Jaystonian/1581-Improved/photos/IMG_20250410_140211_095.jpg

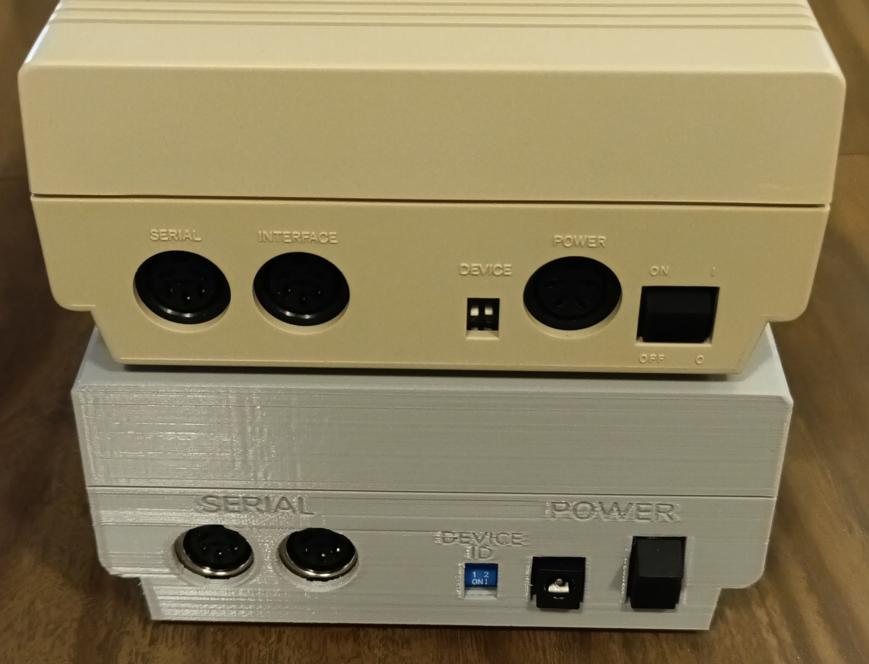
photos/IMG_20250410_140211_095.jpg
