Jaystonian/1581-Improved/photos/IMG_20250410_140146_087.jpg

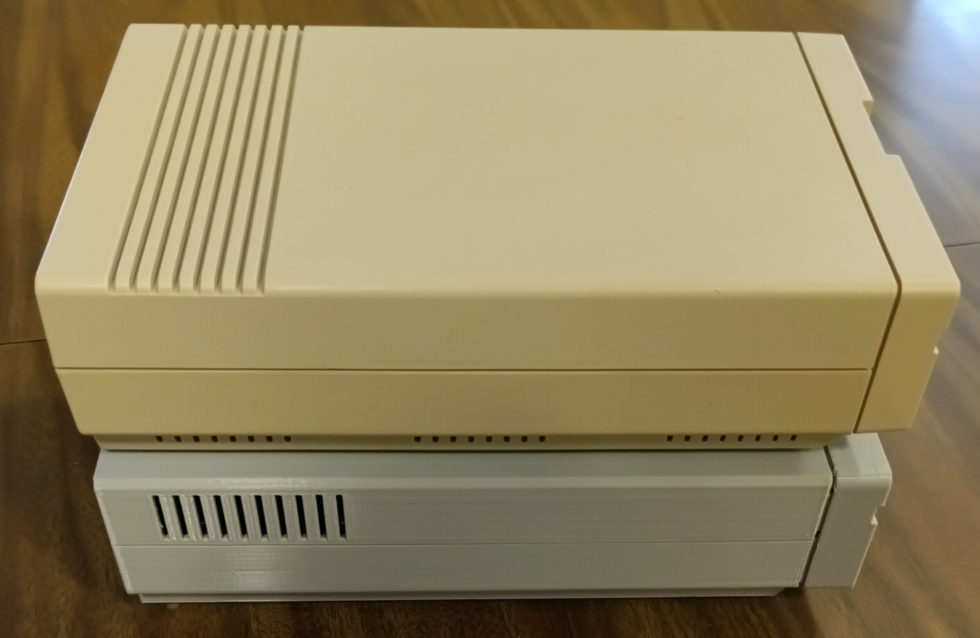
photos/IMG_20250410_140146_087.jpg
