Jaystonian/1581-Improved/photos/1581-improved-bottom.png

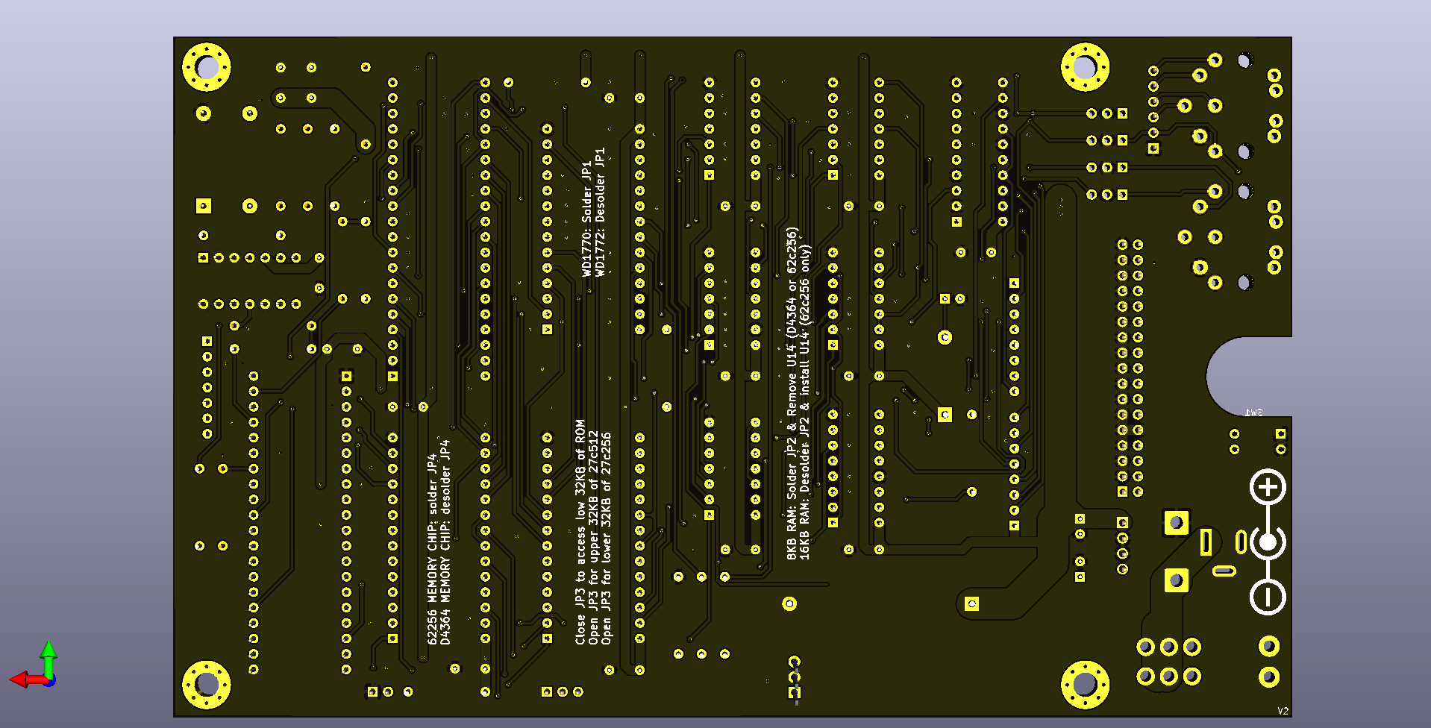
photos/1581-improved-bottom.png
