Jaystonian/1581-Improved/photos/1581-improved-top.png

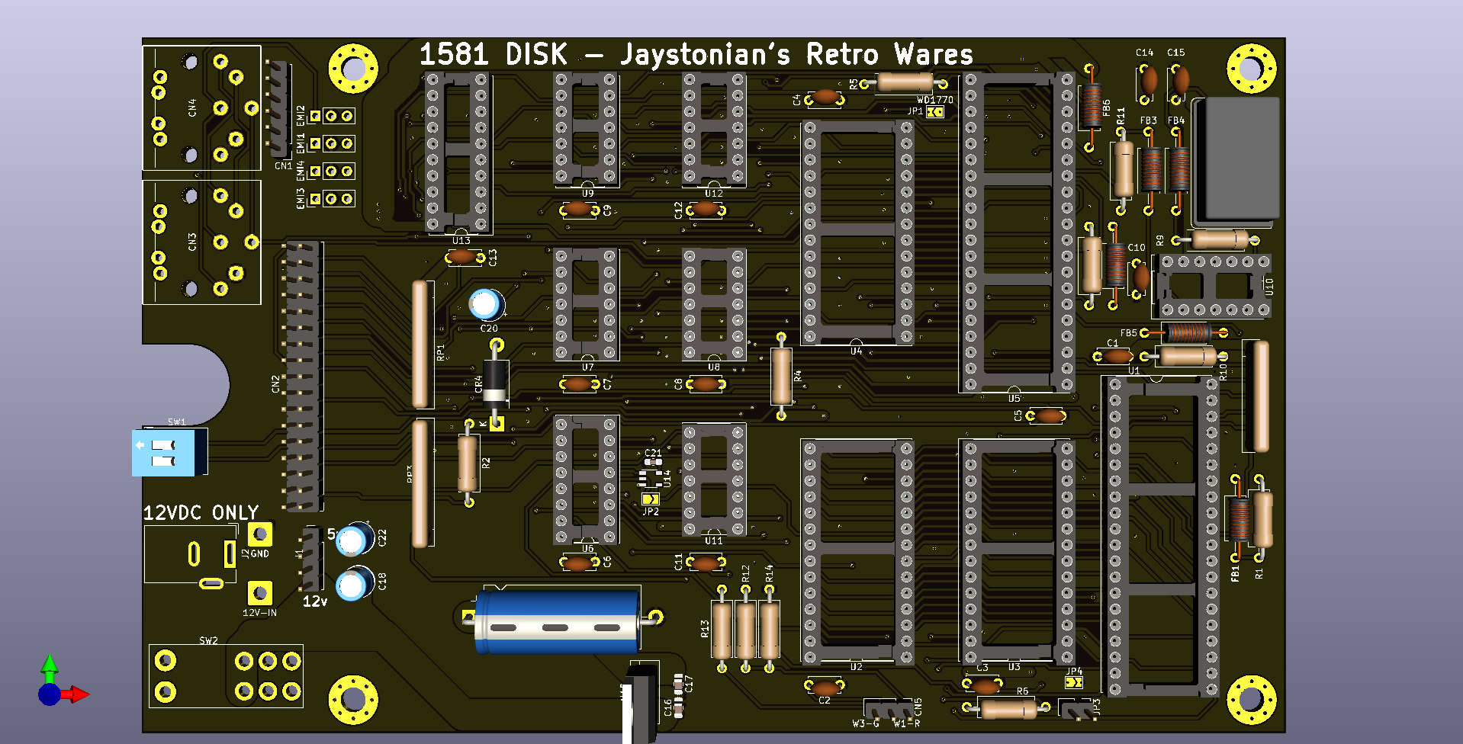
photos/1581-improved-top.png
