Jaystonian/1581-Improved/photos/IMG_20250410_140110_550.jpg

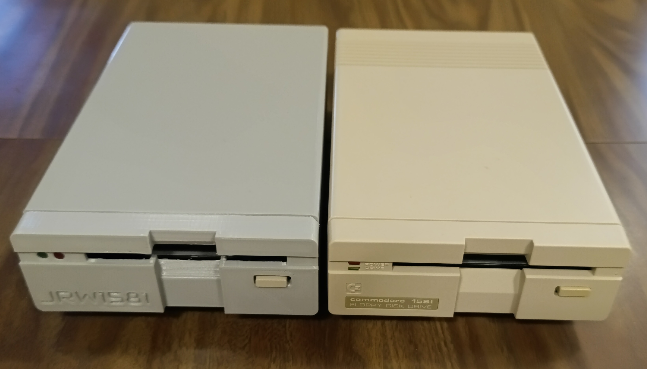
photos/IMG_20250410_140110_550.jpg
