Jaystonian/1581-Improved/STL/JRW1581-Face-HD.stl

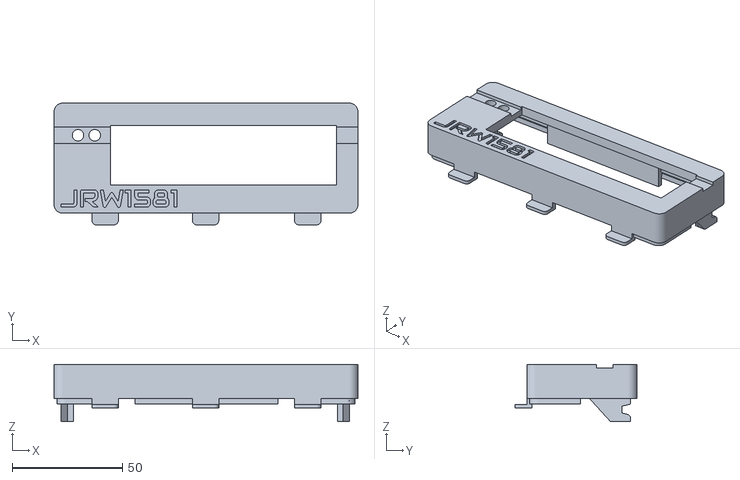
[picture p7: CAD file, 2025-04-21]
STL/JRW1581-Face-HD.stl
138.0 x 55.3 x 26.0
