Jaystonian/1581-Improved/STL/JRW1581-Face-DD-WithSupports.stl

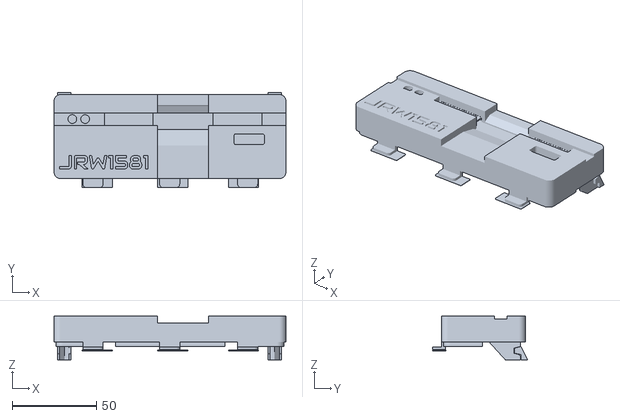
[picture p8: CAD file, 2025-04-21]
STL/JRW1581-Face-DD-WithSupports.stl
138.0 x 56.7 x 26.0
