Jaystonian/1581-Improved/STL/JRW1581-Face-HD-WithSupports.stl

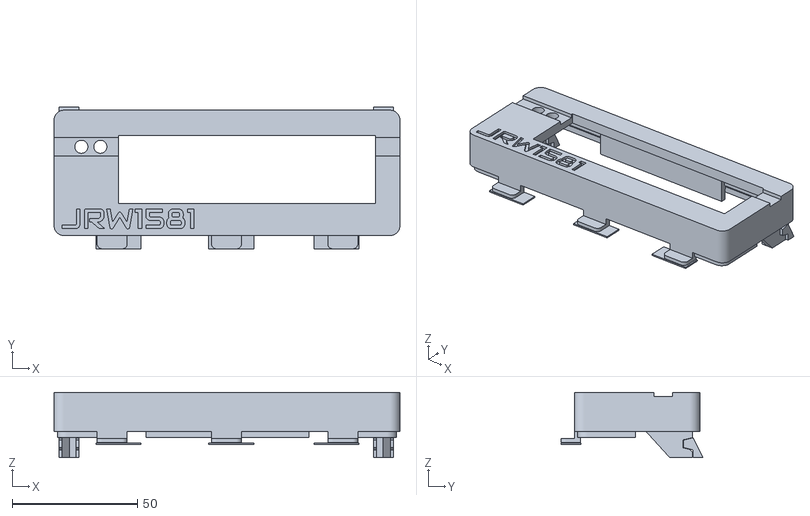
[picture p9: CAD file, 2025-04-21]
STL/JRW1581-Face-HD-WithSupports.stl
138.0 x 56.7 x 26.0
