Jaystonian/1581-Improved/STL/JRW1581-DriveMount-DD.stl

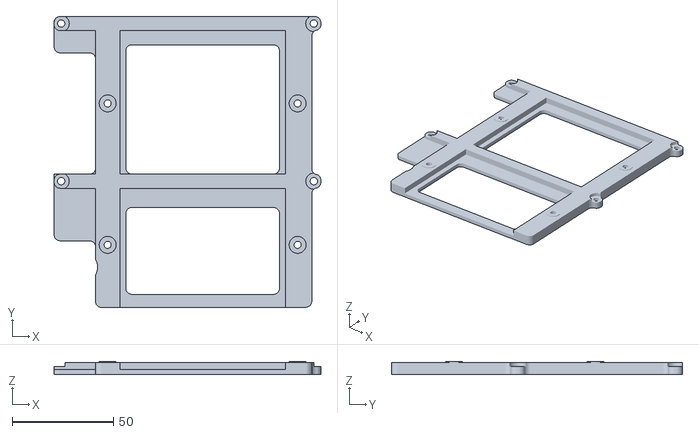
[picture p10: CAD file, 2025-04-21]
STL/JRW1581-DriveMount-DD.stl
132.0 x 144.0 x 6.40
