Jaystonian/1581-Improved/STL/JRW1581-Top.stl

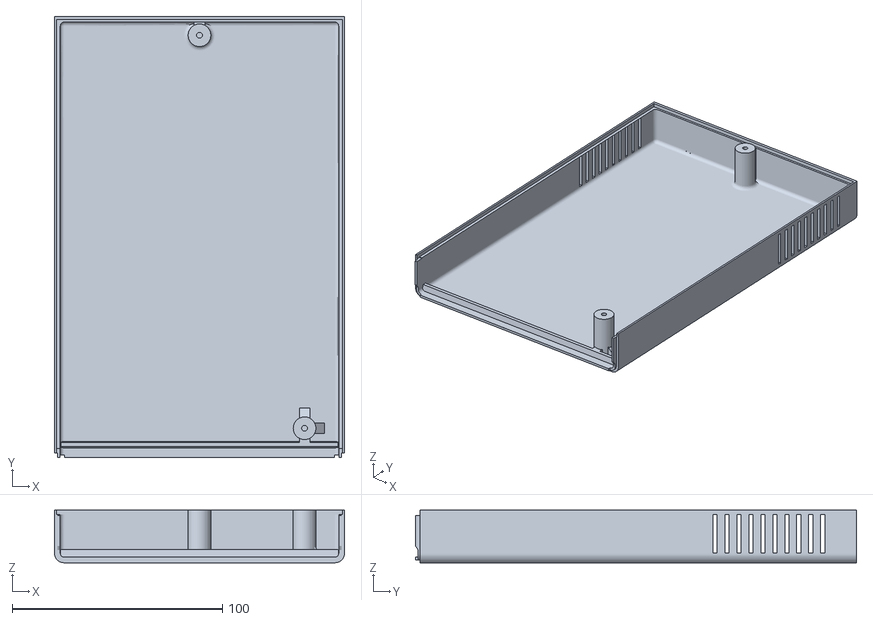
[picture p11: CAD file, 2025-04-10]
STL/JRW1581-Top.stl
138.0 x 210.0 x 25.0
