Jaystonian/1581-Improved/STL/JRW1581-Bottom-With-Print-Supports.stl

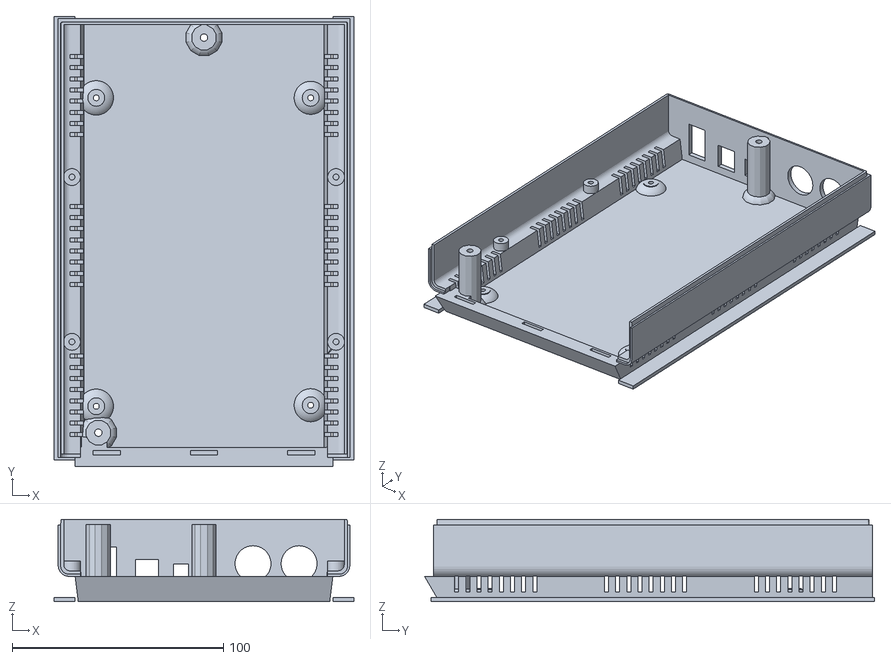
[picture p12: CAD file, 2025-04-10]
STL/JRW1581-Bottom-With-Print-Supports.stl
142.0 x 213.0 x 39.0
