Jaystonian/1581-Improved/STL/JRW1581-Top-With-Print-Support.stl

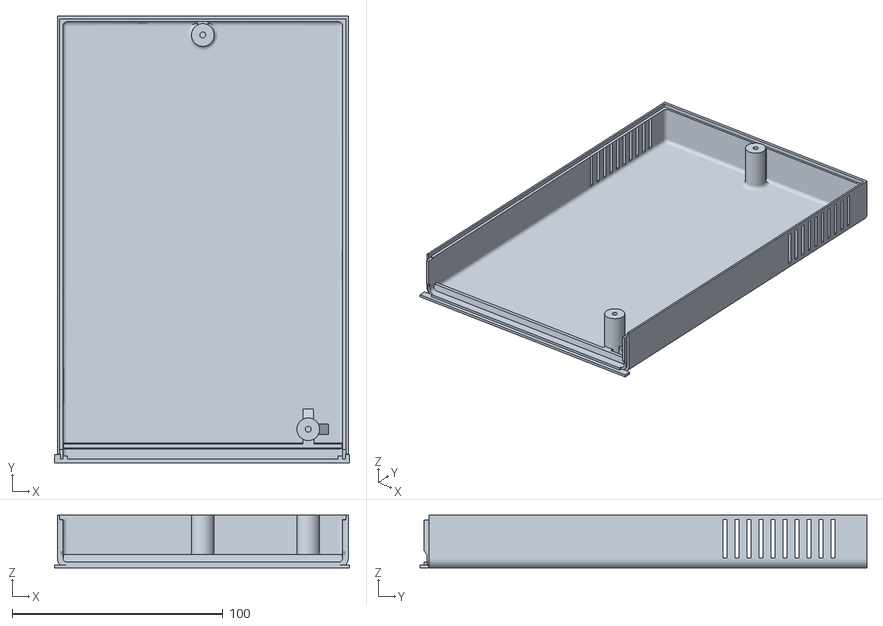
[picture p13: CAD file, 2025-04-10]
STL/JRW1581-Top-With-Print-Support.stl
140.0 x 212.0 x 25.0
