Jaystonian/1581-Improved/STL/JRW1581-Bottom.stl

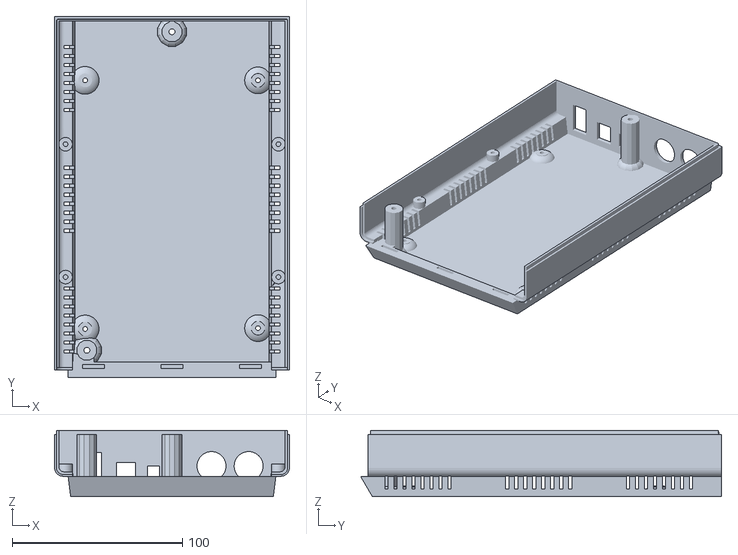
[picture p14: CAD file, 2025-04-10]
STL/JRW1581-Bottom.stl
138.0 x 212.0 x 39.0
