Jaystonian/1581-Improved/(list of files, cad)

Other CAD files:
STL/JRW1581-DriveMount-HD.stl
