Jaystonian/1581-Improved/PDF/1581-improved.pdf

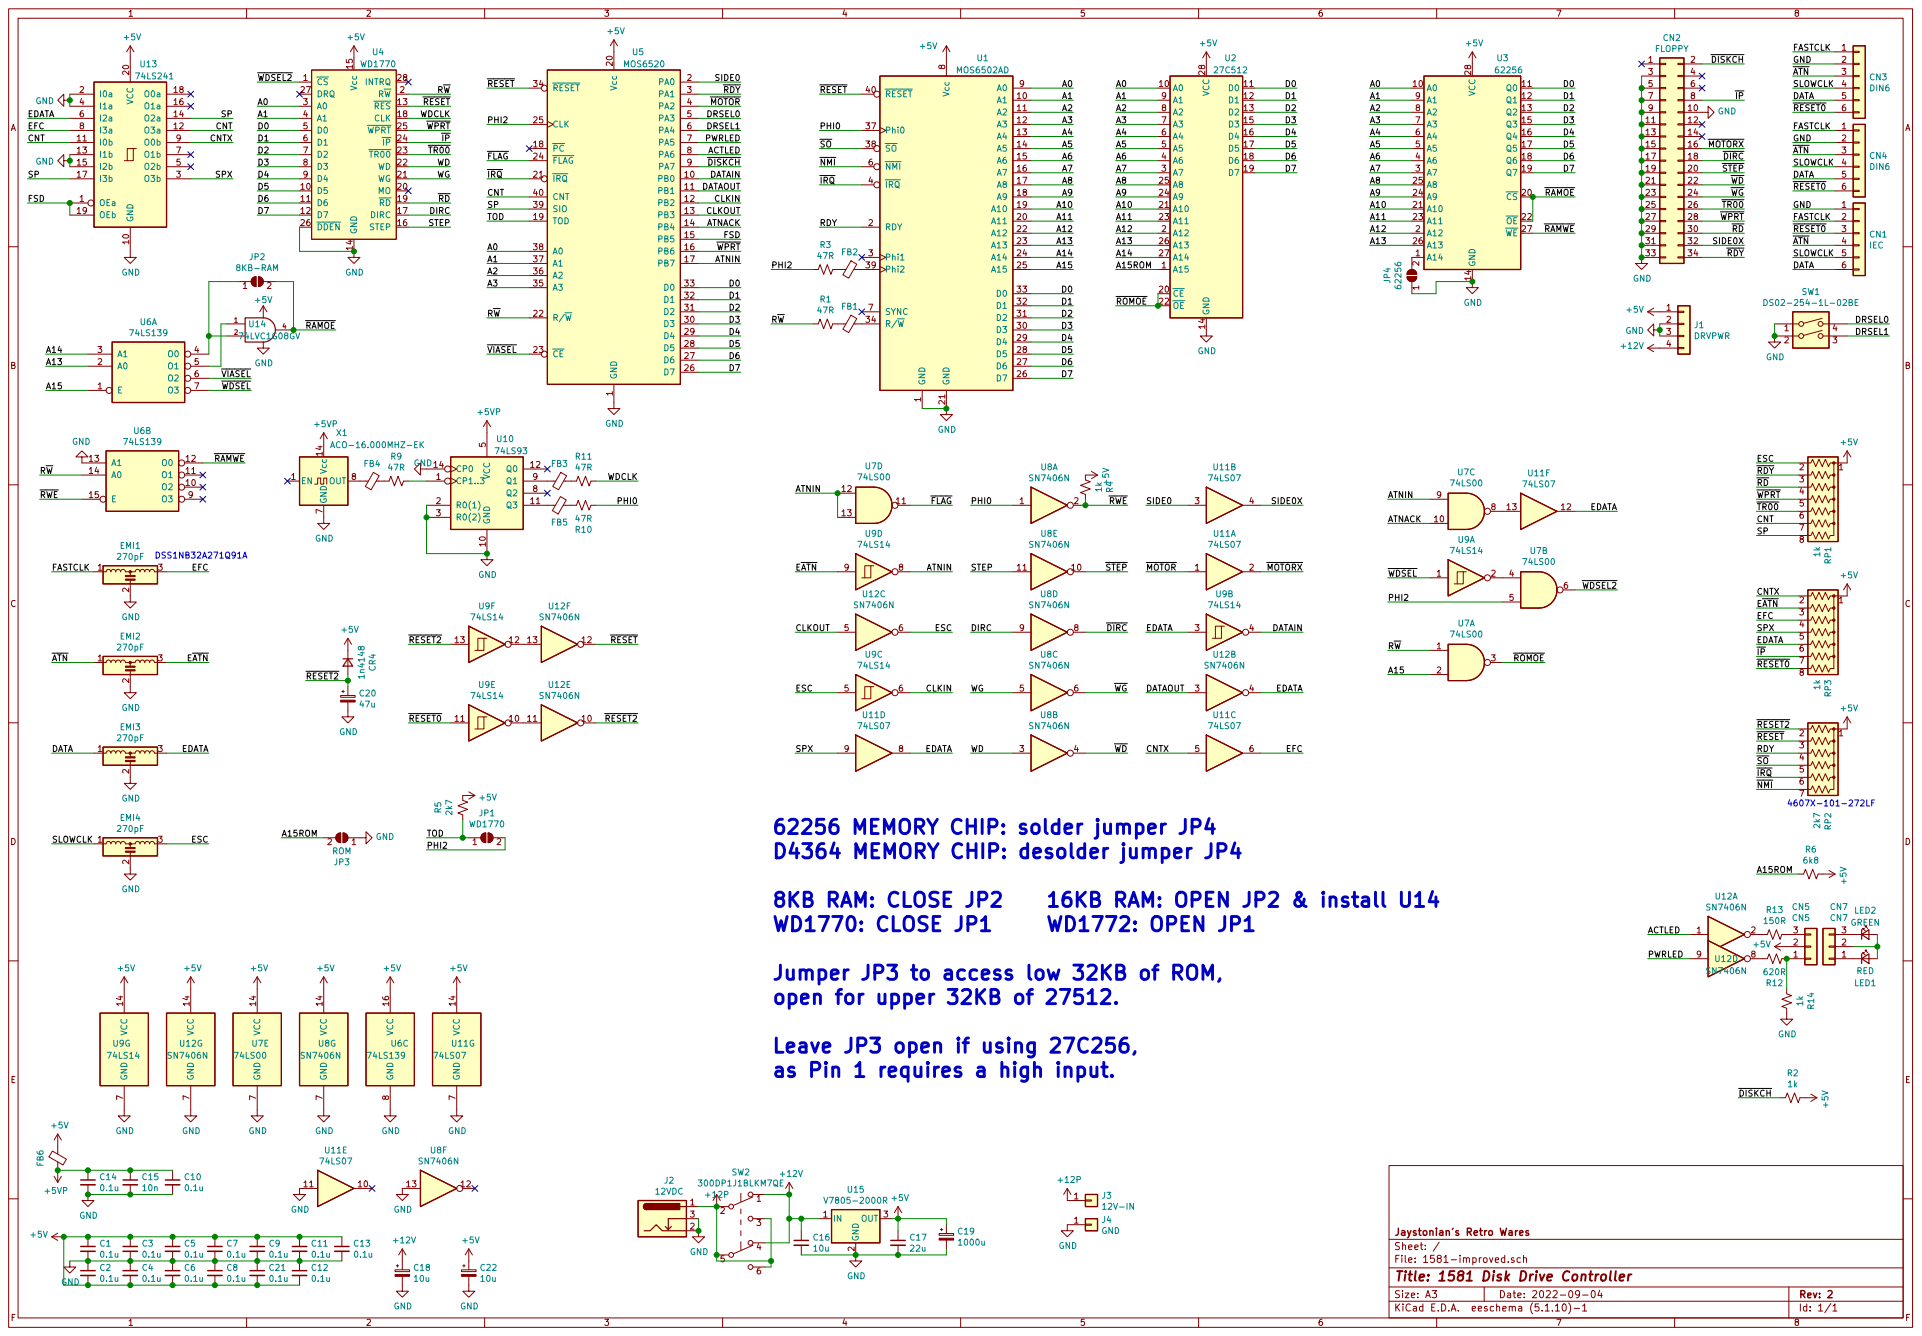
[picture p15: page 1]

D4364 MEMORY CHIP: desolder jumper JP4

File: 1581-improved.sch Sheet: / Jaystonian's Retro Wares GND GND

8KB RAM: CLOSE JP2 16KB RAM: OPEN JP2 & install U14
WD1770: CLOSE JP1 WD1772: OPEN JP1

Jumper JP3 to access low 32KB of ROM,
open for upper 32KB of 27512.

Leave JP3 open if using 27C256,
as Pin 1 requires a high input.

Id: 1/1 Title: 1581 Disk Drive Controller
