Jaystonian/1581-Improved/kicad/1581-improved.kicad_pcb

## KiCad design kicad/1581-improved.kicad_pcb (2025-04-11)

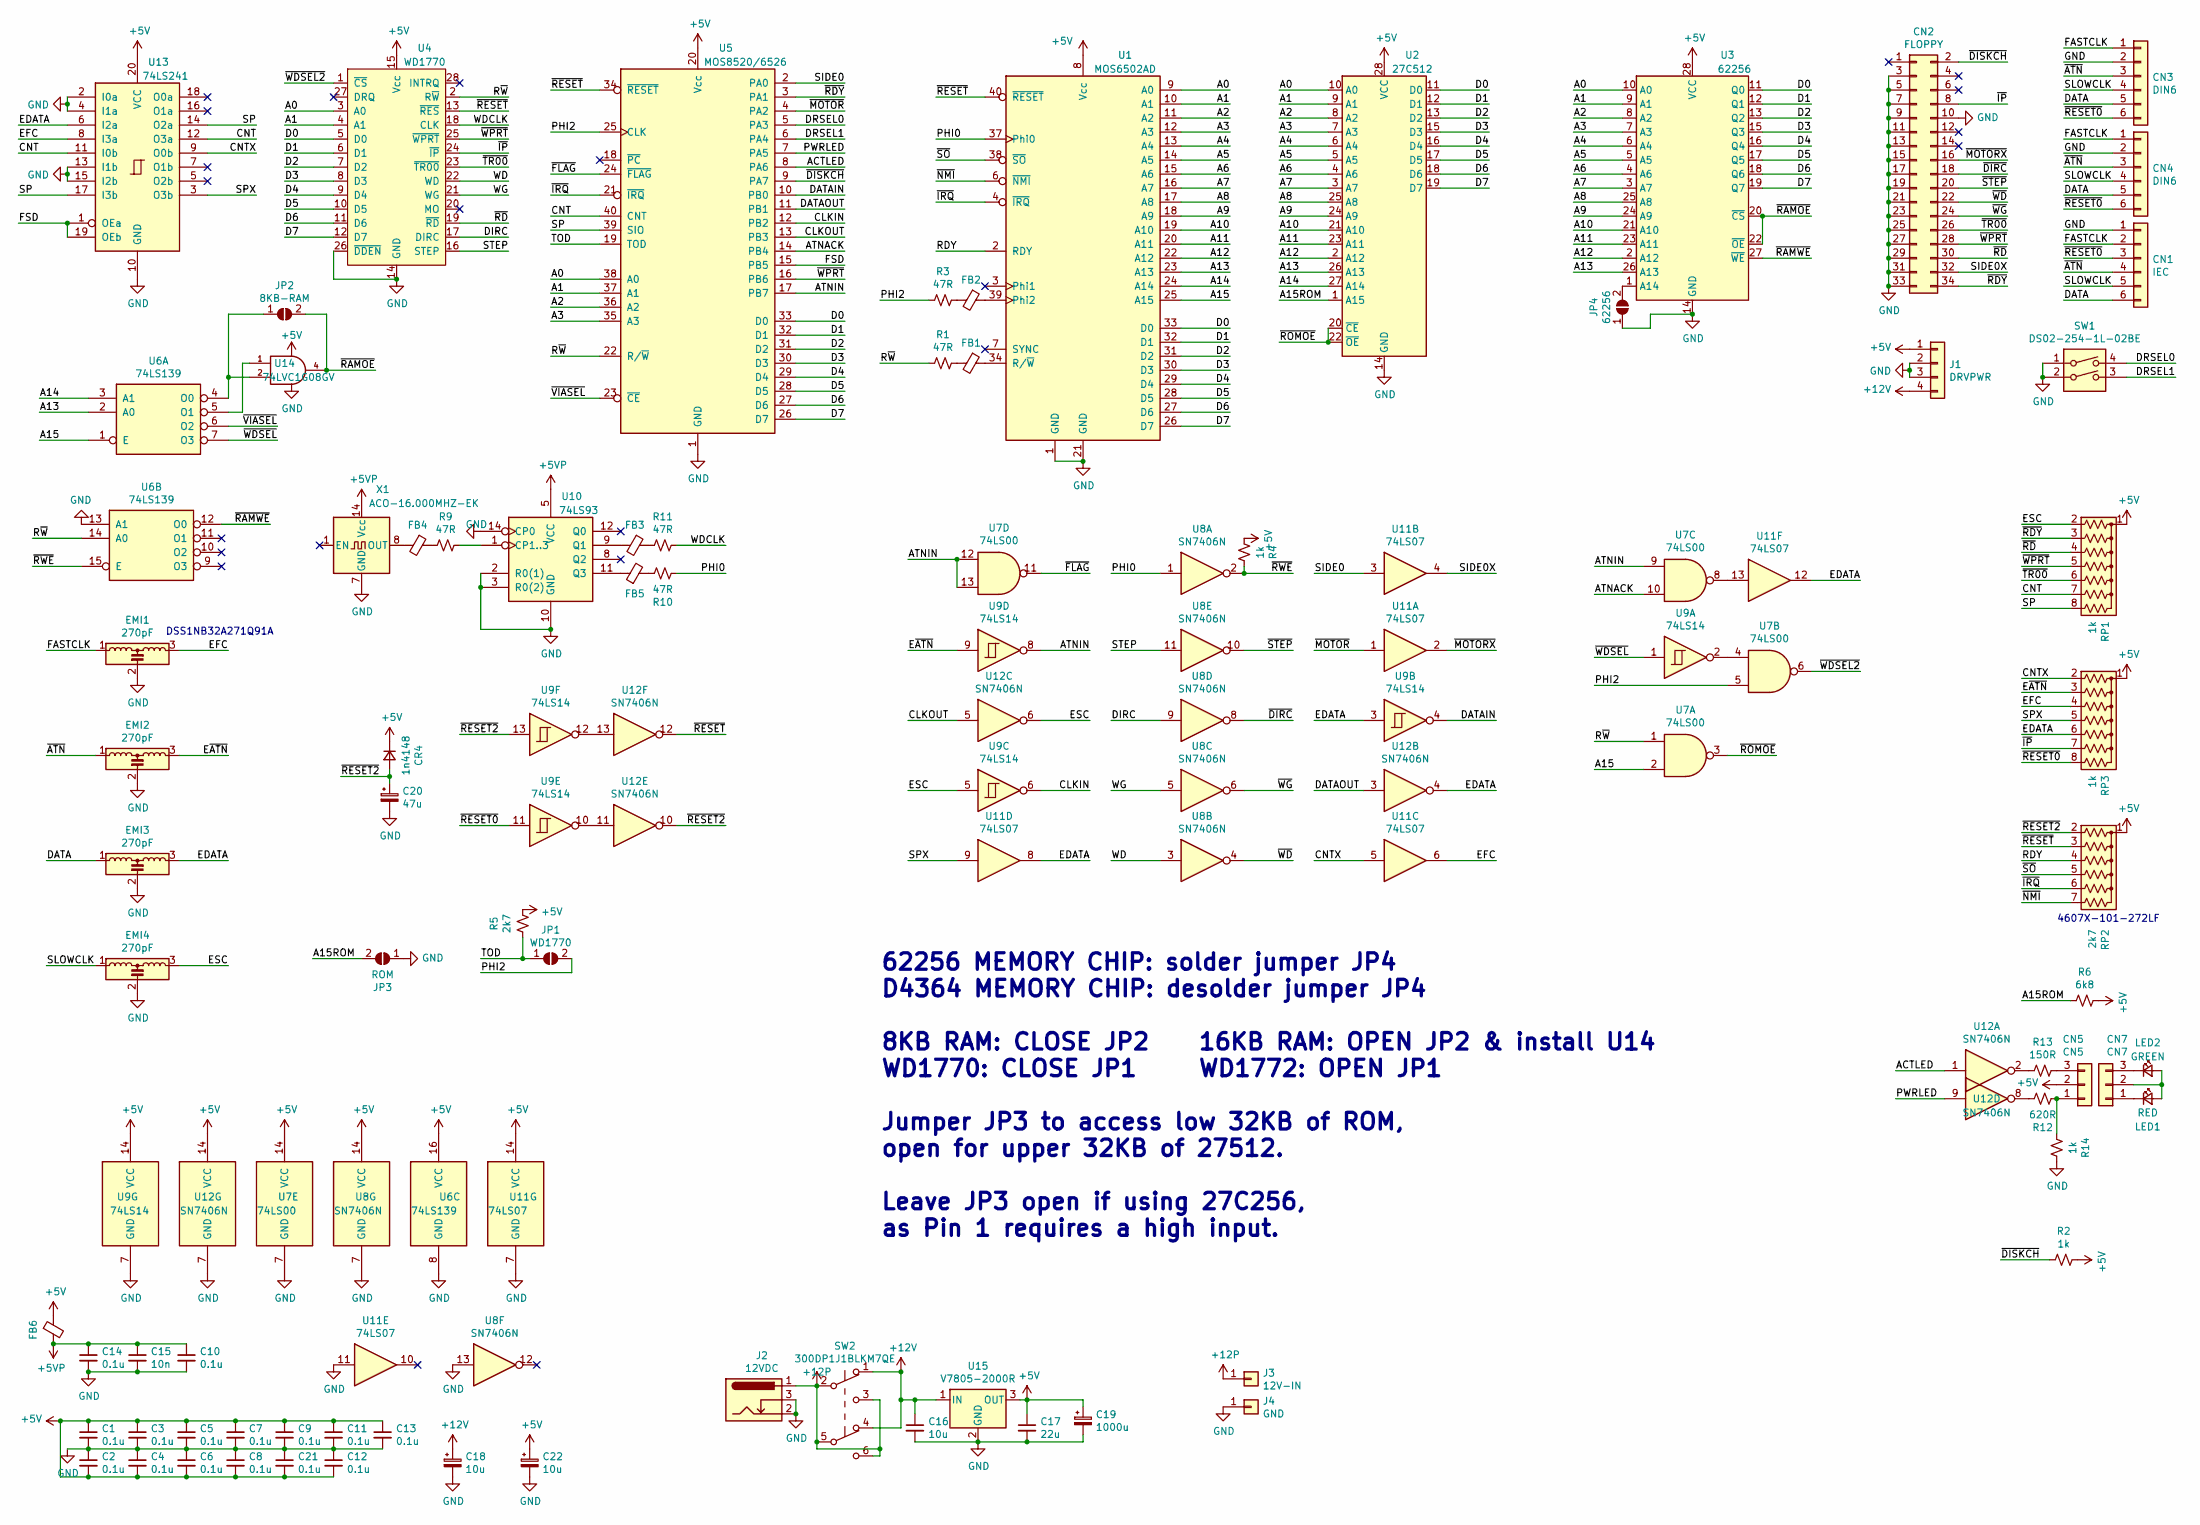
[picture p16: schematic 1581-improved.kicad_sch, 1581 Disk Drive Controller]

Parts:
C1, C2, C3, C4, C5, C6, C7, C8, C9, C10, C11, C12, C13, C14: 0.1u; C_Disc_D5.0mm_W2.5mm_P5.00mm
C15: 10n; C_Disc_D5.0mm_W2.5mm_P5.00mm
C16: 10u; C_0805_2012Metric_Pad1.18x1.45mm_HandSolder
C17: 22u; C_0805_2012Metric_Pad1.18x1.45mm_HandSolder
C18, C22: 10u; CP_Radial_D5.0mm_P2.50mm
C19: 1000u; CP_Axial_L25.0mm_D10.0mm_P30.00mm_Horizontal
C20: 47u; CP_Radial_D5.0mm_P2.50mm
C21: 0.1u; C_0603_1608Metric_Pad1.08x0.95mm_HandSolder
CN1: IEC; PinHeader_1x06_P2.54mm_Vertical
CN2: FLOPPY; PinHeader_2x17_P2.54mm_Vertical
CN3, CN4: DIN6; SDF-60J_DIN-6-240
CN5: CN5; PinHeader_1x03_P2.54mm_Vertical
CN7: CN7; PinHeader_1x03_P2.54mm_Vertical
CR4: 1n4148; D_DO-15_P12.70mm_Horizontal
EMI1, EMI2, EMI3, EMI4: 270pF; PinHeader_1x03_P2.54mm_Vertical
FB1, FB2, FB3, FB4, FB5, FB6: Ferrite_Bead_Small; L_Axial_L7.0mm_D3.3mm_P12.70mm_Horizontal_Fastron_MICC
J1: DRVPWR; PinHeader_1x04_P2.54mm_Vertical
J2: 12VDC; BarrelJack_Wuerth_6941xx301002
J3: 12V-IN; SolderWire-1.5sqmm_1x01_D1.7mm_OD3.9mm
J4: GND; SolderWire-1.5sqmm_1x01_D1.7mm_OD3.9mm
JP1: WD1770; SolderJumper-2_P1.3mm_Open_TrianglePad1.0x1.5mm
JP2: 8KB-RAM; SolderJumper-2_P1.3mm_Open_TrianglePad1.0x1.5mm
JP3: ROM; PinHeader_1x02_P2.54mm_Vertical
JP4: 62256; SolderJumper-2_P1.3mm_Open_TrianglePad1.0x1.5mm
LED1: RED; LED_D3.0mm
LED2: GREEN; LED_D3.0mm
R1, R3, R9, R10, R11: 47R; R_Axial_DIN0309_L9.0mm_D3.2mm_P12.70mm_Horizontal
R2, R4, R14: 1k; R_Axial_DIN0309_L9.0mm_D3.2mm_P12.70mm_Horizontal
R5: 2k7; R_Axial_DIN0309_L9.0mm_D3.2mm_P12.70mm_Horizontal
R6: 6k8; R_Axial_DIN0309_L9.0mm_D3.2mm_P12.70mm_Horizontal
R12: 620R; R_Axial_DIN0309_L9.0mm_D3.2mm_P12.70mm_Horizontal
R13: 150R; R_Axial_DIN0309_L9.0mm_D3.2mm_P12.70mm_Horizontal
RP1, RP3: 1k; R_Array_SIP8
RP2: 2k7; R_Array_SIP7
SW1: DS02-254-1L-02BE; SW_DIP_SPSTx02_Slide_9.78x7.26mm_W7.62mm_P2.54mm
SW2: 300DP1J1BLKM7QE; DPDT_1581
U1: MOS6502AD; DIP-40_W15.24mm_Socket
U2: 27C512; DIP-28_W15.24mm_Socket
U3: 62256; DIP-28_W15.24mm_Socket
U4: WD1770; DIP-28_W15.24mm_Socket
U5: MOS8520/6526; DIP-40_W15.24mm_Socket
U6: 74LS139; DIP-16_W7.62mm_Socket
U7: 74LS00; DIP-14_W7.62mm_Socket
U8, U12: SN7406N; DIP-14_W7.62mm_Socket
U9: 74LS14; DIP-14_W7.62mm_Socket
U10: 74LS93; DIP-14_W7.62mm_Socket
U11: 74LS07; DIP-14_W7.62mm_Socket
U13: 74LS241; DIP-20_W7.62mm_Socket
U14: 74LVC1G08GV; SOT-753
U15: V7805-2000R; TO-220-3_Vertical
X1: ACO-16.000MHZ-EK; Oscillator_DIP-14_LargePads

Connections:
+5V: C1.1, C2.2, C3.1, C4.2, C5.1, C6.2, C7.1, C8.2, C9.1, C11.1, C12.2, C13.1, C17.1, C19.1, C21.2, C22.1, CN5.2, CR4.1 (K), FB6.1, J1.1, R2.1, R4.2, R5.1, R6.1, RP1.1 (common), RP2.1 (common), RP3.1 (common), U1.8 (Vcc), U2.28 (VCC), U3.28 (VCC), U4.15 (Vcc), U5.20 (Vcc), U6.16 (VCC), U7.14 (VCC), U8.14 (VCC), U9.14 (VCC), U11.14 (VCC), U12.14 (VCC), U13.20 (VCC), U14.5 (VCC), U15.3 (OUT)
+5VP: C10.1, C14.1, C15.1, FB6.2, U10.5 (VCC), X1.14 (Vcc)
+12P: J2.1, J3.1, SW2.2 (B), SW2.3 (C), SW2.5 (B), SW2.6 (C)
+12V: C16.1, C18.1, J1.4, SW2.1 (A), SW2.4 (A), U15.1 (IN)
/A0: U1.9 (A0), U2.10 (A0), U3.10 (A0), U4.3 (A0), U5.38 (A0)
/A1: U1.10 (A1), U2.9 (A1), U3.9 (A1), U4.4 (A1), U5.37 (A1)
/A2: U1.11 (A2), U2.8 (A2), U3.8 (A2), U5.36 (A2)
/A3: U1.12 (A3), U2.7 (A3), U3.7 (A3), U5.35 (A3)
/A4: U1.13 (A4), U2.6 (A4), U3.6 (A4)
/A5: U1.14 (A5), U2.5 (A5), U3.5 (A5)
/A6: U1.15 (A6), U2.4 (A6), U3.4 (A6)
/A7: U1.16 (A7), U2.3 (A7), U3.3 (A7)
/A8: U1.17 (A8), U2.25 (A8), U3.25 (A8)
/A9: U1.18 (A9), U2.24 (A9), U3.24 (A9)
/A10: U1.19 (A10), U2.21 (A10), U3.21 (A10)
/A11: U1.20 (A11), U2.23 (A11), U3.23 (A11)
/A12: U1.22 (A12), U2.2 (A12), U3.2 (A12)
/A13: U1.23 (A13), U2.26 (A13), U3.26 (A13), U6.2 (A0)
/A14: U1.24 (A14), U2.27 (A14), U6.3 (A1)
/A15: U1.25 (A15), U6.1 (E), U7.2
/A15ROM: JP3.2 (B), R6.2, U2.1 (A15)
/ACTLED: U5.8 (PA6), U12.1
/ATNACK: U5.14 (PB4), U7.10
/ATNIN: U5.17 (PB7), U7.9, U7.12, U7.13, U9.8
/CLKIN: U5.12 (PB2), U9.6
/CLKOUT: U5.13 (PB3), U12.5
/CNT: RP1.7 (R6), U5.40 (CNT), U13.11 (I0b), U13.12 (O3a)
/CNTX: RP3.2 (R1), U11.5, U13.9 (O0b)
/D0: U1.33 (D0), U2.11 (D0), U3.11 (Q0), U4.5 (D0), U5.33 (D0)
/D1: U1.32 (D1), U2.12 (D1), U3.12 (Q1), U4.6 (D1), U5.32 (D1)
/D2: U1.31 (D2), U2.13 (D2), U3.13 (Q2), U4.7 (D2), U5.31 (D2)
/D3: U1.30 (D3), U2.15 (D3), U3.15 (Q3), U4.8 (D3), U5.30 (D3)
/D4: U1.29 (D4), U2.16 (D4), U3.16 (Q4), U4.9 (D4), U5.29 (D4)
/D5: U1.28 (D5), U2.17 (D5), U3.17 (Q5), U4.10 (D5), U5.28 (D5)
/D6: U1.27 (D6), U2.18 (D6), U3.18 (Q6), U4.11 (D6), U5.27 (D6)
/D7: U1.26 (D7), U2.19 (D7), U3.19 (Q7), U4.12 (D7), U5.26 (D7)
/DATA: CN1.6, CN3.5, CN4.5, EMI3.1
/DATAIN: U5.10 (PB0), U9.4
/DATAOUT: U5.11 (PB1), U12.3
/DIRC: U4.17 (DIRC), U8.9
/DRSEL0: SW1.4, U5.5 (PA3)
/DRSEL1: SW1.3, U5.6 (PA4)
/EDATA: EMI3.3, RP3.6 (R5), U9.3, U11.8, U11.12, U12.4, U13.6 (I2a)
/EFC: EMI1.3, RP3.4 (R3), U11.6, U13.8 (I3a)
/ESC: EMI4.3, RP1.2 (R1), U9.5, U12.6
/E~ATN: EMI2.3, RP3.3 (R2), U9.9
/FASTCLK: CN1.2, CN3.1, CN4.1, EMI1.1
/FSD: U5.15 (PB5), U13.1 (OEa), U13.19 (OEb)
/PHI0: R10.2, U1.37 (Phi0), U8.1
/PHI2: JP1.2 (B), R3.2, U5.25 (CLK), U7.5
/PWRLED: U5.7 (PA5), U12.9
/RDY: RP2.4 (R3), U1.2 (RDY)
/R~W: R1.2, U4.2 (R~W), U5.22 (R/~W), U6.14 (A0), U7.1
/SIDE0: U5.2 (PA0), U11.3
/SIDE0X: CN2.32, U11.4
/SLOWCLK: CN1.5, CN3.4, CN4.4, EMI4.1
/SP: RP1.8 (R7), U5.39 (SIO), U13.14 (O2a), U13.17 (I3b)
/SPX: RP3.5 (R4), U11.9, U13.3 (O3b)
/STEP: U4.16 (STEP), U8.11
/TOD: JP1.1 (A), R5.2, U5.19 (TOD)
/WD: U4.22 (WD), U8.3
/WDCLK: R11.1, U4.18 (CLK)
/WG: U4.21 (WG), U8.5
/~ATN: CN1.4, CN3.3, CN4.3, EMI2.1
/~DIRC: CN2.18, U8.8
/~DISKCH: CN2.2, R2.2, U5.9 (PA7)
/~FLAG: U5.24 (~FLAG), U7.11
/~IP: CN2.8, RP3.7 (R6), U4.24 (~IP)
/~IRQ: RP2.6 (R5), U1.4 (~IRQ), U5.21 (~IRQ)
/~MOTORX: CN2.16, U11.2
/~MOTOR: U5.4 (PA2), U11.1
/~NMI: RP2.7 (R6), U1.6 (~NMI)
/~RAMOE: JP2.2 (B), U3.20 (~CS), U3.22 (~OE), U14.4
/~RAMWE: U3.27 (~WE), U6.12 (O0)
/~RDY: CN2.34, RP1.3 (R2), U5.3 (PA1)
/~RD: CN2.30, RP1.4 (R3), U4.19 (~RD)
/~RESET0: CN1.3, CN3.6, CN4.6, RP3.8 (R7), U9.11
/~RESET2: C20.1, CR4.2 (A), RP2.2 (R1), U9.13, U12.10
/~RESET: RP2.3 (R2), U1.40 (~RESET), U4.13 (~RES), U5.34 (~RESET), U12.12
/~ROMOE: U2.20 (~CE), U2.22 (~OE), U7.3
/~RWE: R4.1, U6.15 (E), U8.2
/~SO: RP2.5 (R4), U1.38 (~SO)
/~STEP: CN2.20, U8.10
/~TR00: CN2.26, RP1.6 (R5), U4.23 (~TR00)
/~VIASEL: U5.23 (~CE), U6.6 (O2)
/~WDSEL2: U4.1 (~CS), U7.6
/~WDSEL: U6.7 (O3), U9.1
/~WD: CN2.22, U8.4
/~WG: CN2.24, U8.6
/~WPRT: CN2.28, RP1.5 (R4), U4.25 (~WPRT), U5.16 (PB6)
GND: C1.2, C2.1, C3.2, C4.1, C5.2, C6.1, C7.2, C8.1, C9.2, C10.2, C11.2, C12.1, C13.2, C14.2, C15.2, C16.2, C17.2, C18.2, C19.2, C20.2, C21.1, C22.2, CN1.1, CN2.3, CN2.5, CN2.7, CN2.9, CN2.10, CN2.11, CN2.13, CN2.15, CN2.17, CN2.19, CN2.21, CN2.23, CN2.25, CN2.27, CN2.29, CN2.31, CN2.33, CN3.2, CN4.2, EMI1.2, EMI2.2, EMI3.2, EMI4.2, J1.2, J1.3, J2.2, J2.3, J4.1, JP3.1 (A), JP4.1 (A), R14.1, SW1.1, SW1.2, U1.1 (GND), U1.21 (GND), U2.14 (GND), U3.14 (GND), U4.14 (GND), U4.26 (~DDEN), U5.1 (GND), U6.8 (GND), U6.13 (A1), U7.7 (GND), U8.7 (GND), U8.13, U9.7 (GND), U10.2 (R0(1)), U10.3 (R0(2)), U10.10 (GND), U10.14 (CP0), U11.7 (GND), U11.11, U12.7 (GND), U13.2 (I0a), U13.4 (I1a), U13.10 (GND), U13.13 (I1b), U13.15 (I2b), U14.3 (GND), U15.2 (GND), X1.7 (GND)
unnamed: CN5.1, R12.2, R14.2
unnamed: CN5.3, R13.1
unnamed: CN7.1, LED1.1 (K)
unnamed: CN7.2, LED1.2 (A), LED2.2 (A)
unnamed: CN7.3, LED2.1 (K)
unnamed: FB1.1, U1.34 (R/~W)
unnamed: FB1.2, R1.1
unnamed: FB2.1, U1.39 (Phi2)
unnamed: FB2.2, R3.1
unnamed: FB3.1, R11.2
unnamed: FB3.2, U10.9 (Q1)
unnamed: FB4.1, R9.2
unnamed: FB4.2, X1.8 (OUT)
unnamed: FB5.1, U10.11 (Q3)
unnamed: FB5.2, R10.1
unnamed: JP2.1 (A), U6.4 (O0), U14.2
unnamed: JP4.2 (B), U3.1 (A14)
unnamed: R9.1, U10.1 (CP1..3)
unnamed: R12.1, U12.8
unnamed: R13.2, U12.2
unnamed: U7.4, U9.2
unnamed: U7.8, U11.13
unnamed: U9.10, U12.11
unnamed: U9.12, U12.13
unnamed: U6.5 (O1), U14.1

Notes on the sheet:
4607X-101-272LF
DSS1NB32A271Q91A
62256 MEMORY CHIP: solder jumper JP4 D4364 MEMORY CHIP: desolder jumper JP4 8KB RAM: CLOSE JP2 16KB RAM: OPEN JP2 & install U14 WD1770: CLOSE JP1 WD1772: OPEN JP1 Jumper JP3 to access low 32KB of ROM, open for upper 32KB of 27512. Leave JP3 open if using 27C256, as Pin 1 requires a high input.

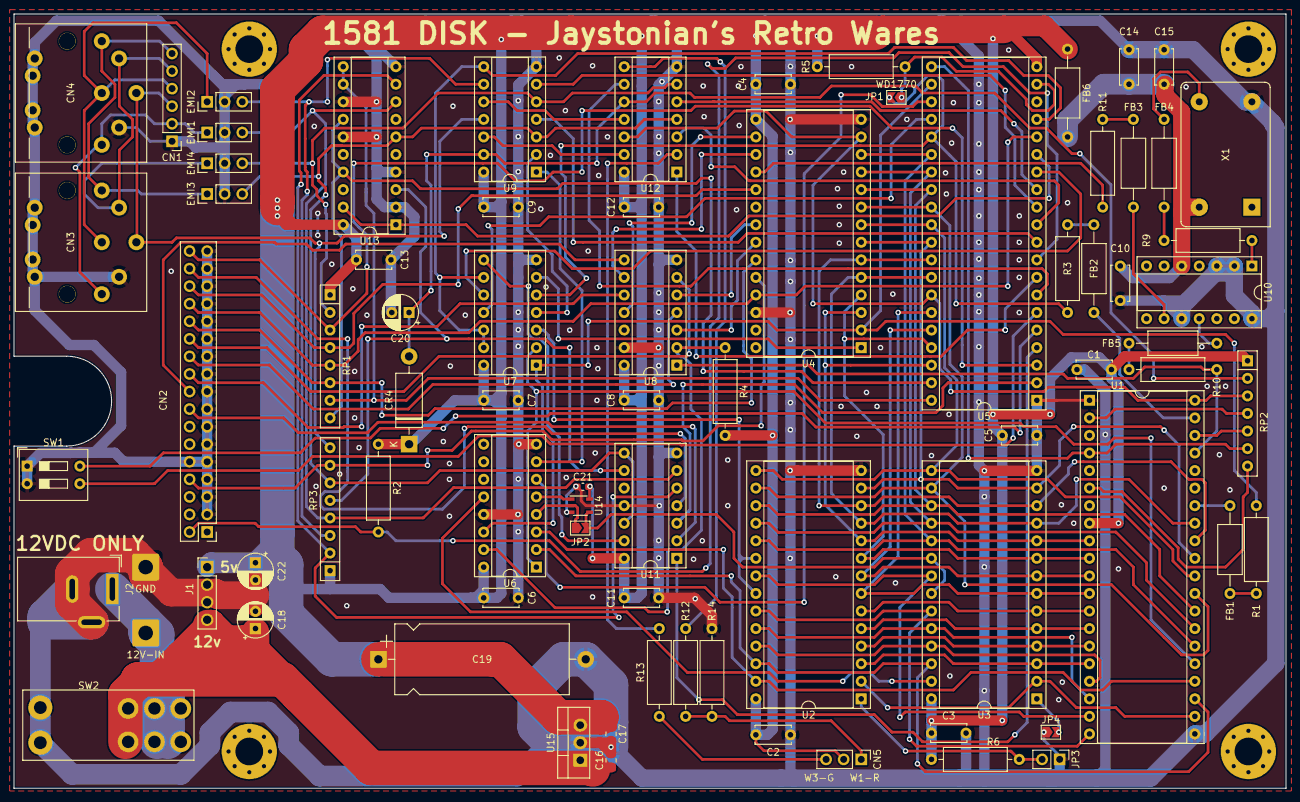
[picture p17: board 1581-improved.kicad_pcb from above]

Board: 2 copper layers, 184.0 x 112.0 mm, 79 parts (0 on the bottom side), 113 nets.
