Jaystonian/1581-Improved/(commit log)

2025-04-10 Small change to reduce upper lip thickness
    [JRW1581-Face-With-Print-Supports.stl, JRW1581-Face.stl]
2025-04-11 Typo on 6520 -> 8520/6526
    [1581-improved.kicad_pcb, 1581-improved.kicad_sch]
2025-04-13 Moved the LED mount 1.5mm
    [JRW1581-Face-With-Print-Supports.stl, JRW1581-Face.stl]
2025-04-21 overhauled the face and mounts
    [JRW1581-DriveMount-DD.stl, JRW1581-DriveMount-HD.stl, JRW1581-Face-DD-WithSupports.stl, JRW1581-Face-DD.stl, JRW1581-Face-HD-WithSupports.stl, JRW1581-Face-HD.stl]
